OutBlade/s6la8/docs/case-top.png

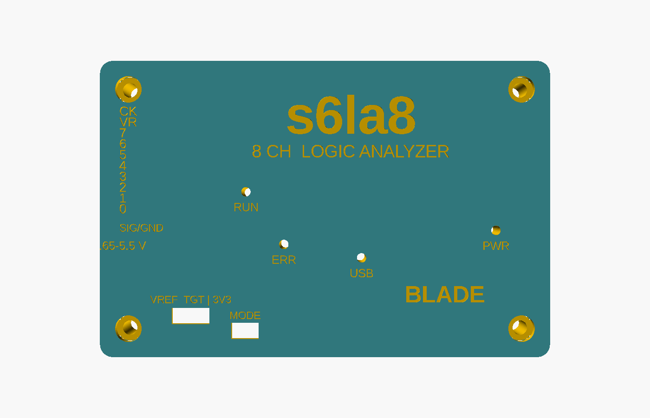
docs/case-top.png
