OutBlade/s6la8/hardware/release/revA/s6la8-revA-bom-jlc.csv

Comment | Designator | Footprint | LCSC Part # | MPN | Manufacturer | Quantity | Note
10uF 10V | C1,C4,C29 | C_0805_2012Metric | C15850 | CL21A106KAYNNNE | Samsung Electro-Mechanics | 3 | JLC basic; 25 V
22uF 6.3V | C2,C3,C5,C6 | C_0805_2012Metric | C45783 | CL21A226MAQNNNE | Samsung Electro-Mechanics | 4 | JLC basic; 25 V
100nF 6.3V | C7,C9,C10,C11,C12,C13,C14,C15,C16,C17,C20,C21,C22,C23,C24,C25,C26,C27,C31,C32,C33,C34,C35,C39,C40,C41,C42,C43,C45,C46,C47,C48,C49,C50,C51,C52,C53,C54,C55 | C_0402_1005Metric | C1525 | CL05B104KO5NNNC | Samsung Electro-Mechanics | 39 | JLC basic
2.2uF 6.3V | C8 | C_0603_1608Metric | C23630 | CL10A225KO8NNNC | Samsung Electro-Mechanics | 1 | JLC basic; 16 V
4.7uF 6.3V | C18,C36,C44 | C_0805_2012Metric | C1779 | CL21A475KAQNNNE | Samsung Electro-Mechanics | 3 | JLC basic; 25 V
1uF | C19 | C_0402_1005Metric | C52923 | CL05A105KA5NQNC | Samsung Electro-Mechanics | 1 | JLC basic; 25 V
10uF 6.3V | C28,C56 | C_0805_2012Metric | C15850 | CL21A106KAYNNNE | Samsung Electro-Mechanics | 2 | JLC basic; 25 V
100nF 10V | C30,C37 | C_0402_1005Metric | C1525 | CL05B104KO5NNNC | Samsung Electro-Mechanics | 2 | JLC basic; 16 V part
1uF 10V | C38 | C_0402_1005Metric | C52923 | CL05A105KA5NQNC | Samsung Electro-Mechanics | 1 | JLC basic; 25 V
18pF | C57,C58 | C_0402_1005Metric | C1549 | CL05C180JB5NNNC | Samsung Electro-Mechanics | 2 | JLC basic; C0G
LED GREEN | D1,D3 | LED_0603_1608Metric |  |  |  | 2 | 0603 green; pick at order
LED RED | D2 | LED_0603_1608Metric |  |  |  | 1 | 0603 red; pick at order
LED YELLOW | D4 | LED_0603_1608Metric |  |  |  | 1 | 0603 yellow; pick at order
220 100MHz | FB1 | R_0603_1608Metric |  |  |  | 1 | ferrite bead 220 ohm at 100 MHz in 0603; pick at order
220 100MHz | FB2 | R_0805_2012Metric |  |  |  | 1 | ferrite bead 220 ohm at 100 MHz in 0805; pick at order
2.54mm 6 x 1 THT Vertical Male | J1 | PinHeader_1x06_P2.54mm_Vertical |  |  |  | 1 | choose at order
2.54mm 2 x 1 THT Vertical Male | J2 | PinHeader_1x02_P2.54mm_Vertical |  |  |  | 1 | choose at order
2.54mm 10 x 2 THT Horizontal Male | J3 | PinHeader_2x10_P2.54mm_Horizontal |  |  |  | 1 | choose at order
USB4105-GF-A | J4 | USB_C_Receptacle_GCT_USB4105-xx-A_16P_TopMnt_Horizontal |  | USB4105-GF-A |  | 1 | IC: MPN is the value
2.54mm 3 x 1 THT Vertical Male | J5 | PinHeader_1x03_P2.54mm_Vertical |  |  |  | 1 | choose at order
2.2uH | L1,L2 | L_1210_3225Metric |  |  |  | 2 | power inductor 2.2 uH, >=1.5 A saturation, 1210; check against TLV62569 datasheet
100k | R1,R2,R3,R9,R11,R13,R15,R17,R19,R21,R23,R28,R40,R61 | R_0402_1005Metric | C25741 | 0402WGF1003TCE | UNI-ROYAL | 14 | JLC basic
453k | R4 | R_0402_1005Metric |  | 0402WGF4533TCE | UNI-ROYAL | 1 | match at order; sets the 3.3 V buck output with 100k
5.1k | R5,R6 | R_0402_1005Metric | C25905 | 0402WGF5101TCE | UNI-ROYAL | 2 | JLC basic
33 | R7,R24,R29,R30,R31,R32,R33,R34,R35,R36,R43 | R_0402_1005Metric | C25105 | 0402WGF330JTCE | UNI-ROYAL | 11 | JLC basic
100 | R8,R10,R12,R14,R16,R18,R20,R22,R27,R60 | R_0402_1005Metric | C25076 | 0402WGF1000TCE | UNI-ROYAL | 10 | JLC basic
1k | R25,R42,R45,R46,R47,R48,R54 | R_0402_1005Metric | C11702 | 0402WGF1001TCE | UNI-ROYAL | 7 | JLC basic
330 | R26 | R_0402_1005Metric | C25104 | 0402WGF3300TCE | UNI-ROYAL | 1 | JLC basic
10k | R37,R38,R39,R41,R51,R52,R57,R58,R59 | R_0402_1005Metric | C25744 | 0402WGF1002TCE | UNI-ROYAL | 9 | JLC basic
4.7k | R44,R49,R50,R53 | R_0402_1005Metric | C25900 | 0402WGF4701TCE | UNI-ROYAL | 4 | JLC basic
2.2k | R55,R56 | R_0402_1005Metric | C25879 | 0402WGF2201TCE | UNI-ROYAL | 2 | JLC basic
24LC128-I/SN | U1 | SOIC-8_3.9x4.9mm_P1.27mm |  | 24LC128-I/SN |  | 1 | IC: MPN is the value
USBLC6-2SC6 | U2,U3,U4,U5,U6 | SOT-23-6 |  | USBLC6-2SC6 |  | 5 | IC: MPN is the value
SN74LVC245APWR | U7 | TSSOP-20_4.4x6.5mm_P0.65mm |  | SN74LVC245APWR |  | 1 | IC: MPN is the value
SN74LVC8T245PWR | U8 | TSSOP-24_4.4x7.8mm_P0.65mm |  | SN74LVC8T245PWR |  | 1 | IC: MPN is the value
SN74LVC2T45DCUR | U9 | VSSOP-8_2.3x2mm_P0.5mm |  | SN74LVC2T45DCUR |  | 1 | IC: MPN is the value
XC6SLX9-2TQG144C | U10 | TQFP-144_20x20mm_P0.5mm | C27408 | XC6SLX9-2TQG144C | AMD Xilinx | 1 | buy from an authorised channel if LCSC stock looks grey-market
CY7C68013A-56PVXC | U11 | SSOP-56_7.5x18.5mm_P0.635mm | C26717 | CY7C68013A-56PVXC | Infineon | 1
TLV62569DBVR | U12,U13 | SOT-23-5 |  | TLV62569DBVR |  | 2 | IC: MPN is the value
MT48LC16M16A2P-6A | U14 | TSOP-II-54_22.2x10.16mm_P0.8mm |  | MT48LC16M16A2P-6A |  | 1 | IC: MPN is the value
ASE-50.000MHZ-LC-T | Y1 | Oscillator_SMD_Abracon_ASE-4Pin_3.2x2.5mm |  | ASE-50.000MHZ-LC-T |  | 1 | IC: MPN is the value
24MHz 12pF | Y2 | Crystal_SMD_3225-4Pin_3.2x2.5mm |  |  |  | 1 | 24 MHz, 12 pF load, 3225; FX2 needs +-100 ppm or better
