OutBlade/s6la8/case/print/s6la8-lid.stl

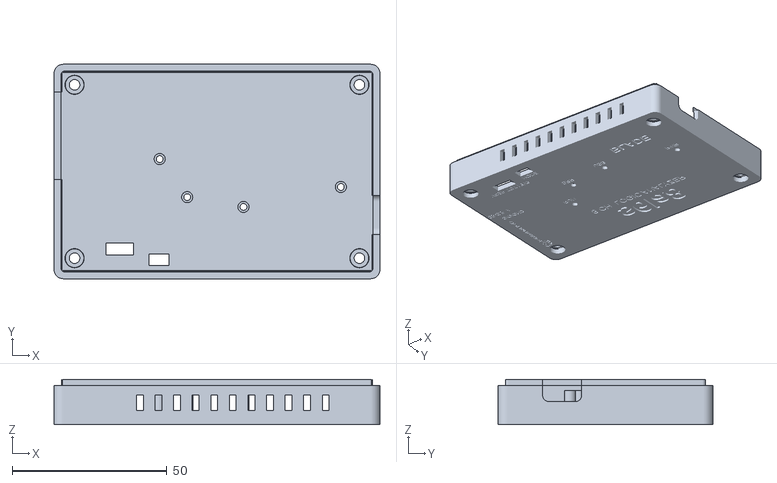
[picture p4: CAD file, 2026-10-16]
case/print/s6la8-lid.stl
105.3 x 69.3 x 14.6
