OutBlade/s6la8/hardware/release/revA/s6la8-revA.step

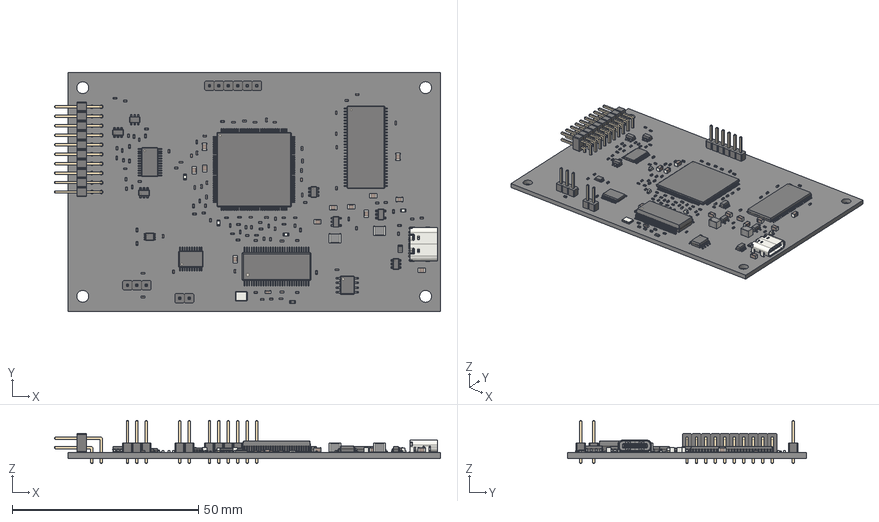
[picture p5: CAD file, 2026-10-16]
hardware/release/revA/s6la8-revA.step
103.6 x 64.0 x 11.5 mm
C_0805_2012Metric x 12
R_0402_1005Metric x 61
SSOP-56_7.5x18.5mm_P0.635mm
SOIC-8_3.9x4.9mm_P1.27mm
C_0402_1005Metric x 45
TSSOP-20_4.4x6.5mm_P0.65mm
C_0603_1608Metric
R_0805_2012Metric
TSOP-II-54_22.2x10.16mm_P0.8mm
R_0603_1608Metric
SOT-23-6 x 5
Crystal_SMD_3225-4Pin_3.2x2.5mm
LED_0603_1608Metric x 4
VSSOP-8_2.3x2mm_P0.5mm
L_1210_3225Metric x 2
SOT-23-5 x 2
USB_C_Receptacle_16P_TopMnt_Horizontal_GCT_USB4105-xx-A
TSSOP-24_4.4x7.8mm_P0.65mm
TQFP-144_20x20mm_P0.5mm
s6la8_PCB
