OutBlade/s6la8/case/print/s6la8-tray.stl

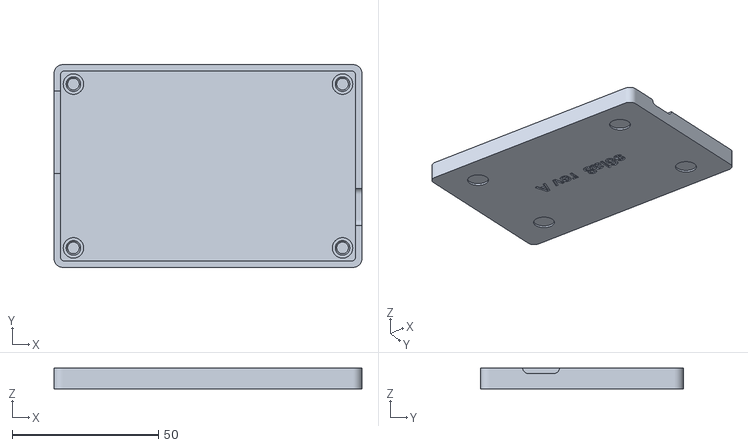
[picture p6: CAD file, 2026-10-16]
case/print/s6la8-tray.stl
105.3 x 69.3 x 7.10
