OutBlade/s6la8/docs/schematic.pdf

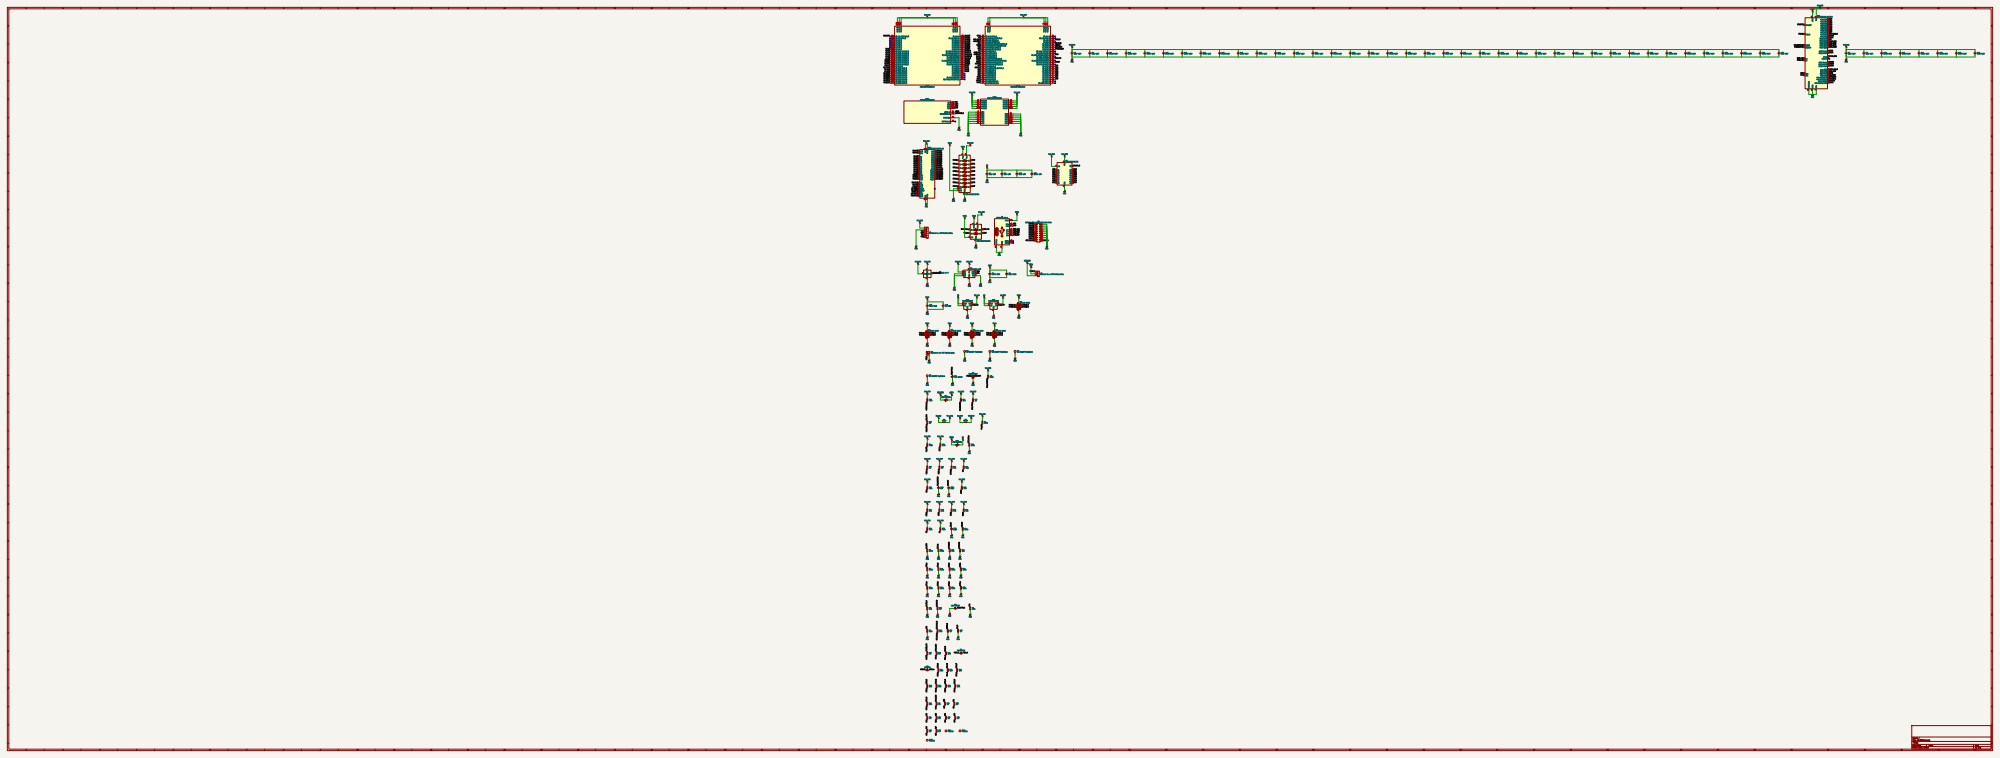
[picture p7: page 1]

2.54mm 2 x 1 THT Vertical Male GND

Size: User | Rev:
KiCad E.D.A. 10.0.6 | Id: 1/1
