OutBlade/s6la8/hardware/release/revA/s6la8-revA-schematic.pdf

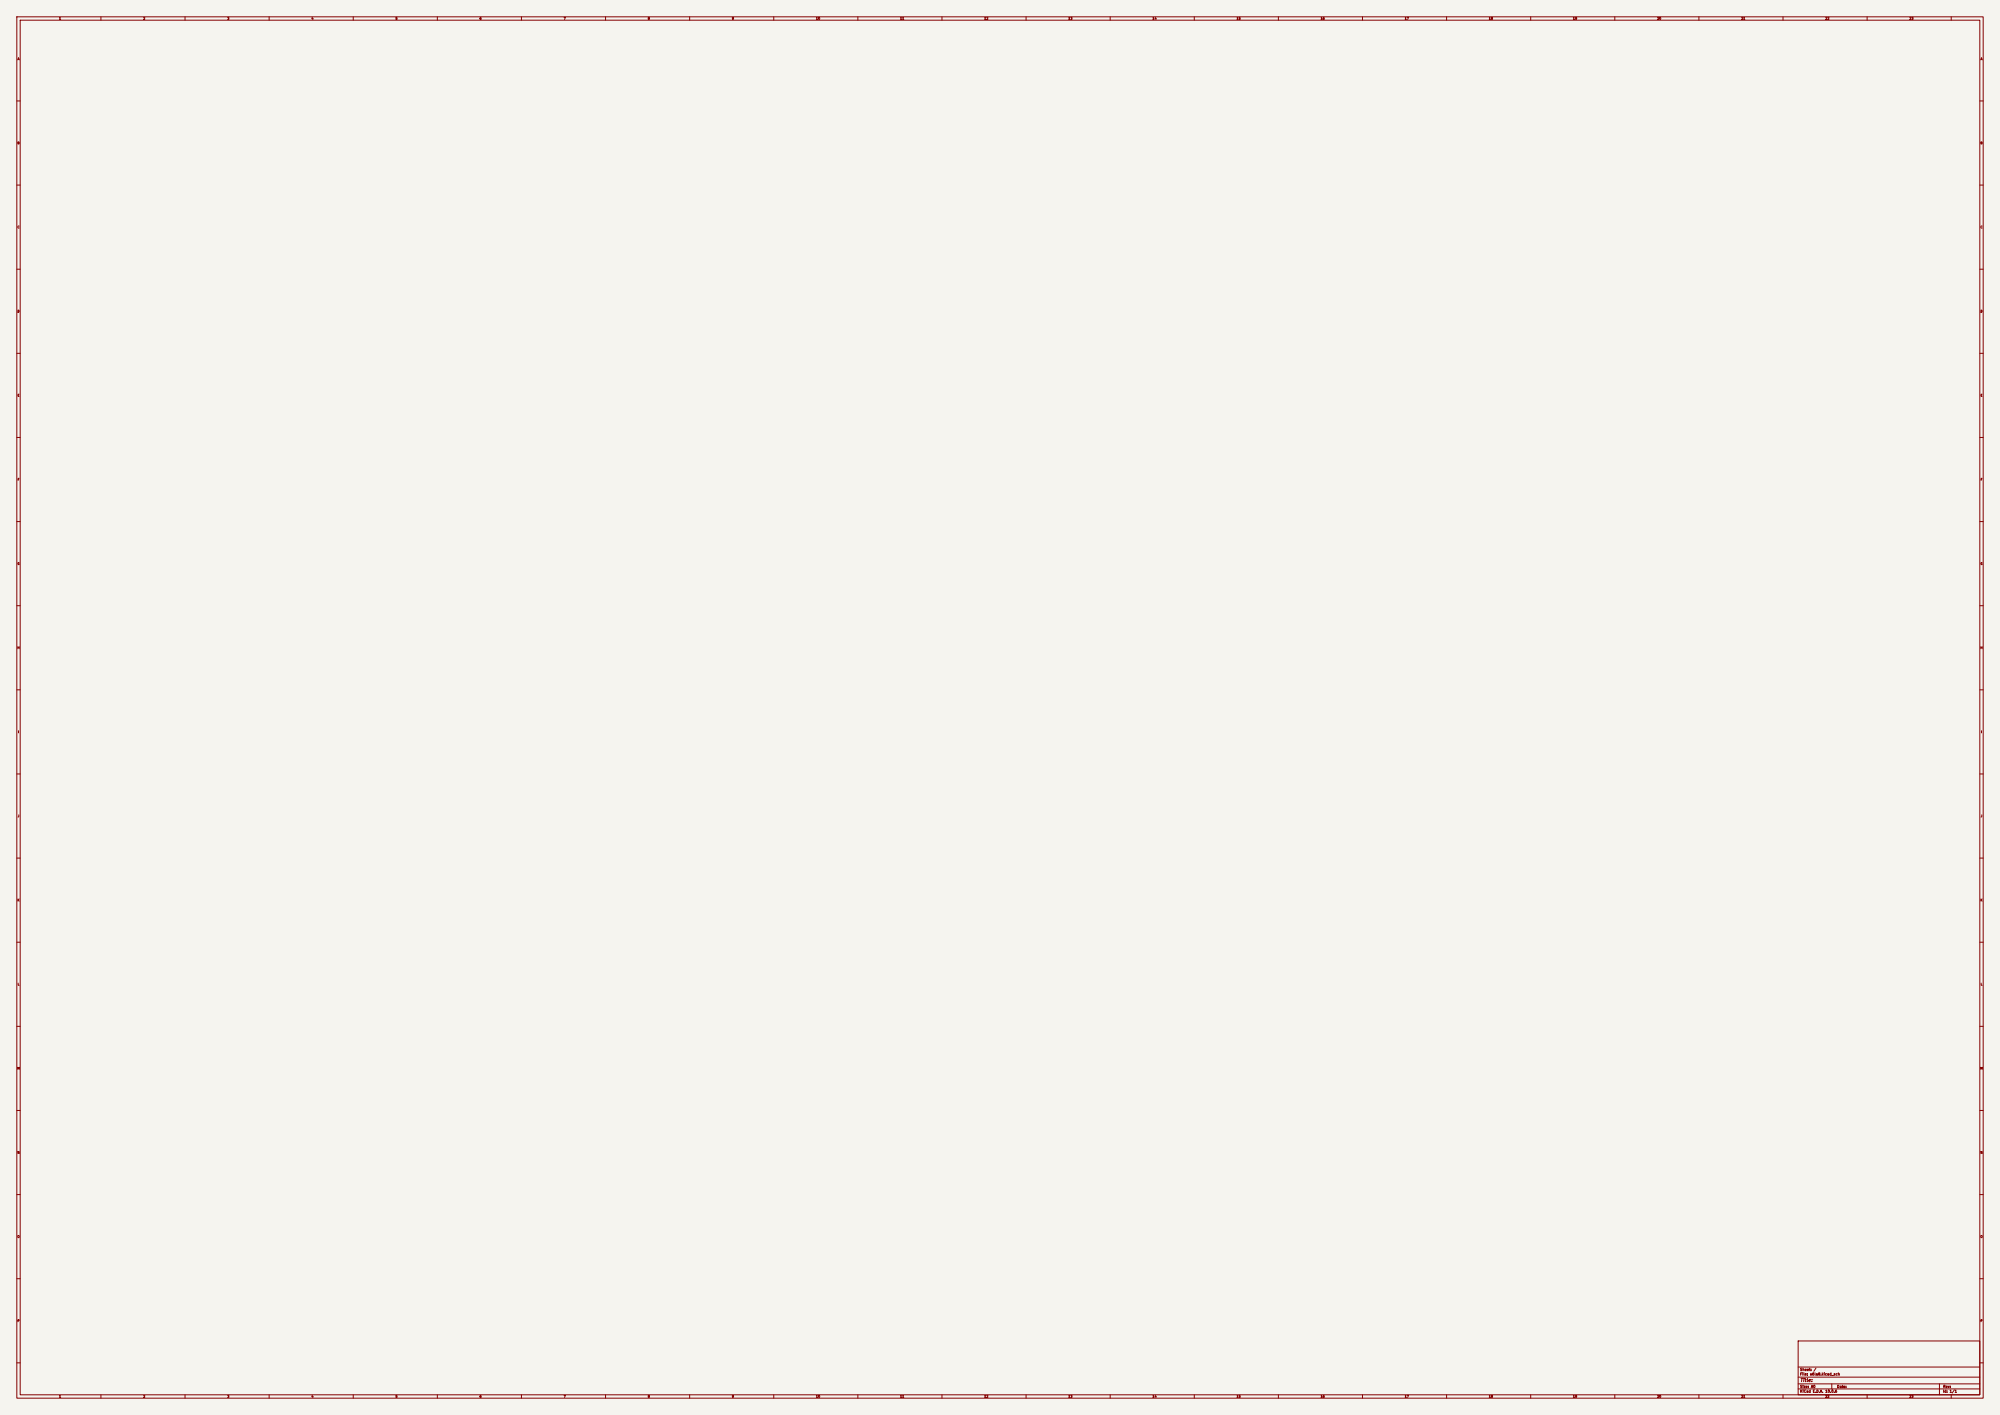
[picture p8: page 1]

Size: A0 | Rev:
KiCad E.D.A. 10.0.6 | Id: 1/1
