OutBlade/s6la8/hardware/release/revA/s6la8-revA-assembly.pdf

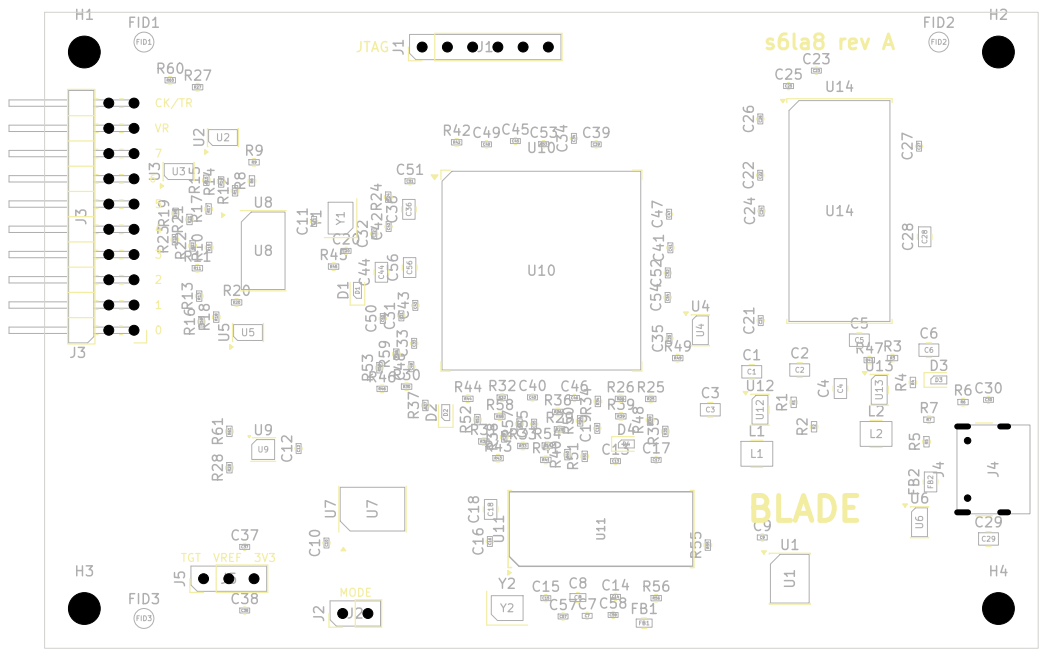
[picture p9: page 1]
