OutBlade/s6la8/hardware/eda/s6la8.kicad_pcb

## KiCad design hardware/eda/s6la8.kicad_pcb (2026-10-16)

Schematic: s6la8.kicad_sch

Parts:
C1, C4, C29: 10uF 10V; C_0805_2012Metric
C2, C3, C5, C6: 22uF 6.3V; C_0805_2012Metric
C7, C9, C10, C11, C12, C13, C14, C15, C16, C17, C20, C21, C22, C23, C24, C25, C26, C27, C31, C32, C33, C34, C35, C39, C40, C41, C42, C43, C45, C46, C47, C48, C49, C50, C51, C52, C53, C54, C55: 100nF 6.3V; C_0402_1005Metric
C8: 2.2uF 6.3V; C_0603_1608Metric
C18, C36, C44: 4.7uF 6.3V; C_0805_2012Metric
C19: 1uF; C_0402_1005Metric
C28, C56: 10uF 6.3V; C_0805_2012Metric
C30, C37: 100nF 10V; C_0402_1005Metric
C38: 1uF 10V; C_0402_1005Metric
C57, C58: 18pF; C_0402_1005Metric
D1, D3: LED GREEN; LED_0603_1608Metric
D2: LED RED; LED_0603_1608Metric
D4: LED YELLOW; LED_0603_1608Metric
FB1: 220 100MHz; R_0603_1608Metric
FB2: 220 100MHz; R_0805_2012Metric
FID1, FID2, FID3: Fiducial; Fiducial_1mm_Mask2mm
H1, H2, H3, H4: M3 DIN965 TopBottom; MountingHole_3.2mm_M3_DIN965_Pad_TopBottom
J1: 2.54mm 6 x 1 THT Vertical Male; PinHeader_1x06_P2.54mm_Vertical
J2: 2.54mm 2 x 1 THT Vertical Male; PinHeader_1x02_P2.54mm_Vertical
J3: 2.54mm 10 x 2 THT Horizontal Male; PinHeader_2x10_P2.54mm_Horizontal
J4: USB4105-GF-A; USB_C_Receptacle_GCT_USB4105-xx-A_16P_TopMnt_Horizontal
J5: 2.54mm 3 x 1 THT Vertical Male; PinHeader_1x03_P2.54mm_Vertical
L1, L2: 2.2uH; L_1210_3225Metric
R1, R2, R3, R9, R11, R13, R15, R17, R19, R21, R23, R28, R40, R61: 100k; R_0402_1005Metric
R4: 453k; R_0402_1005Metric
R5, R6: 5.1k; R_0402_1005Metric
R7, R24, R29, R30, R31, R32, R33, R34, R35, R36, R43: 33; R_0402_1005Metric
R8, R10, R12, R14, R16, R18, R20, R22, R27, R60: 100; R_0402_1005Metric
R25, R42, R45, R46, R47, R48, R54: 1k; R_0402_1005Metric
R26: 330; R_0402_1005Metric
R37, R38, R39, R41, R51, R52, R57, R58, R59: 10k; R_0402_1005Metric
R44, R49, R50, R53: 4.7k; R_0402_1005Metric
R55, R56: 2.2k; R_0402_1005Metric
U1: 24LC128-I/SN; SOIC-8_3.9x4.9mm_P1.27mm
U2, U3, U4, U5, U6: USBLC6-2SC6; SOT-23-6
U7: SN74LVC245APWR; TSSOP-20_4.4x6.5mm_P0.65mm
U8: SN74LVC8T245PWR; TSSOP-24_4.4x7.8mm_P0.65mm
U9: SN74LVC2T45DCUR; VSSOP-8_2.3x2mm_P0.5mm
U10: XC6SLX9-2TQG144C; TQFP-144_20x20mm_P0.5mm
U11: CY7C68013A-56PVXC; SSOP-56_7.5x18.5mm_P0.635mm
U12, U13: TLV62569DBVR; SOT-23-5
U14: MT48LC16M16A2P-6A; TSOP-II-54_22.2x10.16mm_P0.8mm
Y1: ASE-50.000MHZ-LC-T; Oscillator_SMD_Abracon_ASE-4Pin_3.2x2.5mm
Y2: 24MHz 12pF; Crystal_SMD_3225-4Pin_3.2x2.5mm

Connections:
AVCC: C7.1, C8.1, FB1.2, U11.10 (AVCC), U11.14 (AVCC)
CC1: J4.A5 (CC1), R5.1
CC2: J4.B5 (CC2), R6.1
CCLK: R7.2, U10.70 (IO_L1P_CCLK_2)
CCLK_SRC: R7.1, U11.56 (PD4/FD12)
CH0: U7.2 (A1), U8.21 (B1), U10.5 (IO_L52N_3)
CH0_A: R8.2, R9.1, U2.1 (I/O1), U2.6 (I/O1), U8.3 (A1)
CH0_IN: J3.1, R8.1
CH1: U7.3 (A2), U8.20 (B2), U10.6 (IO_L52P_3)
CH1_A: R10.2, R11.1, U2.3 (I/O2), U2.4 (I/O2), U8.4 (A2)
CH1_IN: J3.3, R10.1
CH2: U7.4 (A3), U8.19 (B3), U10.7 (IO_L51N_3)
CH2_A: R12.2, R13.1, U3.1 (I/O1), U3.6 (I/O1), U8.5 (A3)
CH2_IN: J3.5, R12.1
CH3: U7.5 (A4), U8.18 (B4), U10.8 (IO_L51P_3)
CH3_A: R14.2, R15.1, U3.3 (I/O2), U3.4 (I/O2), U8.6 (A4)
CH3_IN: J3.7, R14.1
CH4: U7.6 (A5), U8.17 (B5), U10.9 (IO_L50N_3)
CH4_A: R16.2, R17.1, U4.1 (I/O1), U4.6 (I/O1), U8.7 (A5)
CH4_IN: J3.9, R16.1
CH5: U7.7 (A6), U8.16 (B6), U10.10 (IO_L50P_3)
CH5_A: R18.2, R19.1, U4.3 (I/O2), U4.4 (I/O2), U8.8 (A6)
CH5_IN: J3.11, R18.1
CH6: U7.8 (A7), U8.15 (B7), U10.11 (IO_L49N_3)
CH6_A: R20.2, R21.1, U5.1 (I/O1), U5.6 (I/O1), U8.9 (A7)
CH6_IN: J3.13, R20.1
CH7: U7.9 (A8), U8.14 (B8), U10.12 (IO_L49P_3)
CH7_A: R22.2, R23.1, U5.3 (I/O2), U5.4 (I/O2), U8.10 (A8)
CH7_IN: J3.15, R22.1
CLK50: R24.2, U10.15 (IO_L44P_GCLK21_3)
CLK50_SRC: R24.1, Y1.3 (OUT)
CSI_B: R25.1, U10.64 (IO_L3N_MOSI_CSI_B_MISO0_2)
DONE: R26.2, U10.71 (DONE_2), U11.54 (PD2/FD10)
EXT_CLK: U9.7 (B1), U10.17 (IO_L43P_GCLK23_3)
EXT_CLK_A: R27.2, R28.1, U9.2 (A1)
EXT_CLK_IN: J3.19, R27.1
FB0: R29.1, U7.18 (B1)
FB1: R30.1, U7.17 (B2)
FB2: R31.1, U7.16 (B3)
FB3: R32.1, U7.15 (B4)
FB4: R33.1, U7.14 (B5)
FB5: R34.1, U7.13 (B6)
FB6: R35.1, U7.12 (B7)
FB7: R36.1, U7.11 (B8)
FB_1V2: R1.1, R2.2, U12.5 (FB)
FB_3V3: R3.1, R4.2, U13.5 (FB)
FB_OE_N: R37.1, U7.19 (~OE), U10.30 (IO_L36P_3), U11.43 (PA3/WU2)
FD0: R29.2, U10.48 (IO_L48P_D7_2), U11.25 (PB0/FD0)
FD1: R30.2, U10.43 (IO_L62N_D6_2), U11.26 (PB1/FD1)
FD2: R31.2, U10.44 (IO_L62P_D5_2), U11.27 (PB2/FD2)
FD3: R32.2, U10.45 (IO_L49N_D4_2), U11.28 (PB3/FD3)
FD4: R33.2, U10.46 (IO_L49P_D3_2), U11.29 (PB4/FD4)
FD5: R34.2, U10.61 (IO_L12N_D2_MISO3_2), U11.30 (PB5/FD5)
FD6: R35.2, U10.62 (IO_L12P_D1_MISO2_2), U11.31 (PB6/FD6)
FD7: R36.2, U10.65 (IO_L3P_D0_DIN_MISO_MISO1_2), U11.32 (PB7/FD7)
FIFOADR0: R38.1, U10.58 (IO_L14P_D11_2), U11.44 (PA4/FIOADDR0)
FIFOADR1: R39.1, U10.59 (IO_L13N_D10_2), U11.45 (PA5/FIOADDR1)
FLAGA: U10.51 (IO_L31P_GCLK31_D14_2), U11.36 (CTL0/FLAGA)
FLAGB: U10.56 (IO_L30P_GCLK1_D13_2), U11.37 (CTL1/FLAGB)
FLAGC: U10.57 (IO_L14N_D12_2), U11.38 (CTL2/FLAGC)
FPGA_IRQ_N: U10.26 (IO_L37N_3), U11.40 (PA0/~INT0)
FX2_RESET_N: C19.1, R40.2, U11.49 (~RESET)
FX2_WAKEUP: R41.2, U11.51 (WAKEUP)
GND: C1.2, C2.2, C3.2, C4.2, C5.2, C6.2, C7.2, C8.2, C9.2, C10.2, C11.2, C12.2, C13.2, C14.2, C15.2, C16.2, C17.2, C18.2, C19.2, C20.2, C21.2, C22.2, C23.2, C24.2, C25.2, C26.2, C27.2, C28.2, C29.2, C30.2, C31.2, C32.2, C33.2, C34.2, C35.2, C36.2, C37.2, C38.2, C39.2, C40.2, C41.2, C42.2, C43.2, C44.2, C45.2, C46.2, C47.2, C48.2, C49.2, C50.2, C51.2, C52.2, C53.2, C54.2, C55.2, C56.2, C57.2, C58.2, D3.1 (K), D4.1 (K), H1.1, H2.1, H3.1, H4.1, J1.2, J2.2, J3.2, J3.4, J3.6, J3.8, J3.10, J3.12, J3.14, J3.16, J3.18, J4.A1 (GND), J4.A12 (GND), J4.B1 (GND), J4.B12 (GND), J4.SH (SHIELD), R1.2, R3.2, R5.2, R6.2, R9.2, R11.2, R13.2, R15.2, R17.2, R19.2, R21.2, R23.2, R25.2, R28.2, R37.2, R38.2, R39.2, R42.2, R54.2, R61.2, U1.2 (A1), U1.3 (A2), U1.4 (GND), U1.7 (WP), U2.2 (GND), U3.2 (GND), U4.2 (GND), U5.2 (GND), U6.2 (GND), U7.10 (GND), U8.11 (GND), U8.12 (GND), U8.13 (GND), U8.22 (~OE), U9.4 (GND), U10.3 (GND), U10.13 (GND), U10.25 (GND), U10.49 (GND), U10.54 (GND), U10.68 (GND), U10.73 (SUSPEND), U10.77 (GND), U10.91 (GND), U10.96 (GND), U10.108 (GND), U10.113 (GND), U10.130 (GND), U10.136 (GND), U11.4 (GND), U11.7 (GND), U11.13 (AGND), U11.17 (AGND), U11.19 (GND), U11.21 (RESERVED), U11.33 (GND), U11.35 (GND), U11.48 (GND), U12.2 (GND), U13.2 (GND), U14.6 (VSSQ), U14.12 (VSSQ), U14.28 (VSS), U14.41 (VSS), U14.46 (VSSQ), U14.52 (VSSQ), U14.54 (VSS), Y1.2 (GND), Y2.2 (G), Y2.4 (G)
HSWAPEN: R42.1, U10.144 (IO_L1P_HSWAPEN_0)
IFCLK: R43.2, U10.55 (IO_L30N_GCLK0_USERCCLK_2)
IFCLK_SRC: R43.1, U11.20 (IFCLK)
INIT_B: R44.2, U10.39 (IO_L65P_INIT_B_2), U11.53 (PD1/FD9)
LED1_A: D1.2 (A), R45.2
LED1_K: D1.1 (K), U10.29 (IO_L36N_3)
LED2_A: D2.2 (A), R46.2
LED2_K: D2.1 (K), U10.33 (IO_L2P_3)
LED_PWR_A: D3.2 (A), R47.2
LED_USB: R48.1, U11.41 (PA1/~INT1)
LED_USB_A: D4.2 (A), R48.2
M0: R49.2, U10.69 (IO_L1N_M0_CMPMISO_2), U11.55 (PD3/FD11)
M1: R50.2, U10.60 (IO_L13P_M1_2)
MODE: J2.1, R51.2, U11.47 (PA7/FLAGD/~SLCS)
NC_J_USB_SBU1: J4.A8 (SBU1)
NC_J_USB_SBU2: J4.B8 (SBU2)
NC_U_FPGA_CMPCS_B_2: U10.72 (CMPCS_B_2)
NC_U_FPGA_IO_L1N_VREF_0: U10.143 (IO_L1N_VREF_0)
NC_U_FPGA_IO_L1N_VREF_3: U10.34 (IO_L1N_VREF_3)
NC_U_FPGA_IO_L1P_3: U10.35 (IO_L1P_3)
NC_U_FPGA_IO_L2N_0: U10.141 (IO_L2N_0)
NC_U_FPGA_IO_L2N_3: U10.32 (IO_L2N_3)
NC_U_FPGA_IO_L2P_0: U10.142 (IO_L2P_0)
NC_U_FPGA_IO_L3N_0: U10.139 (IO_L3N_0)
NC_U_FPGA_IO_L3P_0: U10.140 (IO_L3P_0)
NC_U_FPGA_IO_L4P_0: U10.138 (IO_L4P_0)
NC_U_FPGA_IO_L41N_GCLK26_3: U10.23 (IO_L41N_GCLK26_3)
NC_U_FPGA_IO_L41P_GCLK27_3: U10.24 (IO_L41P_GCLK27_3)
NC_U_FPGA_IO_L42N_GCLK24_3: U10.21 (IO_L42N_GCLK24_3)
NC_U_FPGA_IO_L43N_GCLK22_IRDY2_3: U10.16 (IO_L43N_GCLK22_IRDY2_3)
NC_U_FPGA_IO_L44N_GCLK20_3: U10.14 (IO_L44N_GCLK20_3)
NC_U_FPGA_IO_L47N_1: U10.78 (IO_L47N_1)
NC_U_FPGA_IO_L47P_1: U10.79 (IO_L47P_1)
NC_U_FPGA_IO_L74N_DOUT_BUSY_1: U10.74 (IO_L74N_DOUT_BUSY_1)
NC_U_FPGA_IO_L74P_AWAKE_1: U10.75 (IO_L74P_AWAKE_1)
NC_U_FPGA_IO_L83N_VREF_3: U10.1 (IO_L83N_VREF_3)
NC_U_FPGA_IO_L83P_3: U10.2 (IO_L83P_3)
NC_U_FX2_CLKOUT: U11.5 (CLKOUT)
NC_U_SDRAM_NC: U14.40 (NC)
PKTEND: R52.2, U10.50 (IO_L31N_GCLK30_D15_2), U11.46 (PA6/PKTEND)
PROGRAM_B: R53.2, U10.37 (PROGRAM_B_2), U11.52 (PD0/FD8)
RDWR_B: R54.1, U10.47 (IO_L48N_RDWR_B_VREF_2)
REG_CS_N: U10.67 (IO_L2P_CMPCLK_2), U11.3 (PD7/FD15)
REG_MISO: U10.27 (IO_L37P_3), U11.2 (PD6/FD14)
REG_MOSI: U10.66 (IO_L2N_CMPMOSI_2), U11.1 (PD5/FD13)
SCL: R55.2, U1.6 (SCL), U11.22 (SCL)
SDA: R56.2, U1.5 (SDA), U11.23 (SDA)
SD_A0: U10.83 (IO_L45P_1), U14.23 (A0)
SD_A1: U10.82 (IO_L45N_1), U14.24 (A1)
SD_A2: U10.81 (IO_L46P_1), U14.25 (A2)
SD_A3: U10.80 (IO_L46N_1), U14.26 (A3)
SD_A4: U10.137 (IO_L4N_0), U14.29 (A4)
SD_A5: U10.134 (IO_L34P_GCLK19_0), U14.30 (A5)
SD_A6: U10.133 (IO_L34N_GCLK18_0), U14.31 (A6)
SD_A7: U10.132 (IO_L35P_GCLK17_0), U14.32 (A7)
SD_A8: U10.131 (IO_L35N_GCLK16_0), U14.33 (A8)
SD_A9: U10.127 (IO_L36P_GCLK15_0), U14.34 (A9)
SD_A10: U10.84 (IO_L43N_GCLK4_1), U14.22 (A10)
SD_A11: U10.126 (IO_L36N_GCLK14_0), U14.35 (A11)
SD_A12: U10.124 (IO_L37P_GCLK13_0), U14.36 (A12)
SD_BA0: U10.87 (IO_L42N_GCLK6_TRDY1_1), U14.20 (BA0)
SD_BA1: U10.85 (IO_L43P_GCLK5_1), U14.21 (BA1)
SD_CAS_N: U10.93 (IO_L41P_GCLK9_IRDY1_1), U14.17 (~CAS)
SD_CKE: U10.123 (IO_L37N_GCLK12_0), U14.37 (CKE)
SD_CLK: U10.121 (IO_L62P_0), U14.38 (CLK)
SD_CS_N: U10.88 (IO_L42P_GCLK7_1), U14.19 (~CS)
SD_DQ0: U10.105 (IO_L1P_1), U14.2 (DQ0)
SD_DQ1: U10.104 (IO_L1N_VREF_1), U14.4 (DQ1)
SD_DQ2: U10.102 (IO_L32P_1), U14.5 (DQ2)
SD_DQ3: U10.101 (IO_L32N_1), U14.7 (DQ3)
SD_DQ4: U10.100 (IO_L33P_1), U14.8 (DQ4)
SD_DQ5: U10.99 (IO_L33N_1), U14.10 (DQ5)
SD_DQ6: U10.98 (IO_L34P_1), U14.11 (DQ6)
SD_DQ7: U10.97 (IO_L34N_1), U14.13 (DQ7)
SD_DQ8: U10.119 (IO_L63P_SCP7_0), U14.42 (DQ8)
SD_DQ9: U10.118 (IO_L63N_SCP6_0), U14.44 (DQ9)
SD_DQ10: U10.117 (IO_L64P_SCP5_0), U14.45 (DQ10)
SD_DQ11: U10.116 (IO_L64N_SCP4_0), U14.47 (DQ11)
SD_DQ12: U10.115 (IO_L65P_SCP3_0), U14.48 (DQ12)
SD_DQ13: U10.114 (IO_L65N_SCP2_0), U14.50 (DQ13)
SD_DQ14: U10.112 (IO_L66P_SCP1_0), U14.51 (DQ14)
SD_DQ15: U10.111 (IO_L66N_SCP0_0), U14.53 (DQ15)
SD_DQMH: U10.120 (IO_L62N_VREF_0), U14.39 (DQMH)
SD_DQML: U10.95 (IO_L40P_GCLK11_1), U14.15 (DQML)
SD_RAS_N: U10.92 (IO_L41N_GCLK8_1), U14.18 (~RAS)
SD_WE_N: U10.94 (IO_L40N_GCLK10_1), U14.16 (~WE)
SLOE: R57.2, U10.41 (IO_L64P_D8_2), U11.42 (PA2/SLOE)
SLRD: R58.2, U10.40 (IO_L64N_D9_2), U11.8 (RDY0/SLRD)
SLWR: R59.2, U10.38 (IO_L65N_CSO_B_2), U11.9 (RDY1/SLWR)
SW_1V2: L1.1, U12.3 (SW)
SW_3V3: L2.1, U13.3 (SW)
TCK: J1.3, U10.109 (TCK)
TDI: J1.5, U10.110 (TDI)
TDO: J1.4, U10.106 (TDO)
TMS: J1.6, U10.107 (TMS)
TRIG: U9.6 (B2), U10.22 (IO_L42P_GCLK25_TRDY2_3)
TRIG_A: R60.2, R61.1, U9.3 (A2)
TRIG_IN: J3.20, R60.1
USB_D_N: J4.A7 (D-), J4.B7 (D-), U6.3 (I/O2), U6.4 (I/O2), U11.16 (D-)
USB_D_P: J4.A6 (D+), J4.B6 (D+), U6.1 (I/O1), U6.6 (I/O1), U11.15 (D+)
V5: C1.1, C4.1, C29.1, C30.1, FB2.2, U12.1 (EN), U12.4 (VIN), U13.1 (EN), U13.4 (VIN)
VBUS: FB2.1, J4.A4 (VBUS), J4.A9 (VBUS), J4.B4 (VBUS), J4.B9 (VBUS), U6.5 (VBUS)
VCCA: C37.1, C38.1, J5.2, U2.5 (VBUS), U3.5 (VBUS), U4.5 (VBUS), U5.5 (VBUS), U8.1 (V_{CCA}), U8.2 (DIR), U9.1 (VCCA), U9.5 (DIR)
VCC_1V2: C2.1, C3.1, C39.1, C40.1, C41.1, C42.1, C43.1, C44.1, L1.2, R2.1, U10.19 (VCCINT), U10.28 (VCCINT), U10.52 (VCCINT), U10.89 (VCCINT), U10.128 (VCCINT)
VCC_3V3: C5.1, C6.1, C9.1, C10.1, C11.1, C12.1, C13.1, C14.1, C15.1, C16.1, C17.1, C18.1, C20.1, C21.1, C22.1, C23.1, C24.1, C25.1, C26.1, C27.1, C28.1, C31.1, C32.1, C33.1, C34.1, C35.1, C36.1, C45.1, C46.1, C47.1, C48.1, C49.1, C50.1, C51.1, C52.1, C53.1, C54.1, C55.1, C56.1, FB1.1, J1.1, J5.3, L2.2, R4.1, R26.1, R40.1, R41.1, R44.1, R45.1, R46.1, R47.1, R49.1, R50.1, R51.1, R52.1, R53.1, R55.1, R56.1, R57.1, R58.1, R59.1, U1.1 (A0), U1.8 (VCC), U7.1 (DIR), U7.20 (VCC), U8.23 (V_{CCB}), U8.24 (V_{CCB}), U9.8 (VCCB), U10.4 (VCCO_3), U10.18 (VCCO_3), U10.20 (VCCAUX), U10.31 (VCCO_3), U10.36 (VCCAUX), U10.42 (VCCO_2), U10.53 (VCCAUX), U10.63 (VCCO_2), U10.76 (VCCO_1), U10.86 (VCCO_1), U10.90 (VCCAUX), U10.103 (VCCO_1), U10.122 (VCCO_0), U10.125 (VCCO_0), U10.129 (VCCAUX), U10.135 (VCCO_0), U11.6 (VCC), U11.18 (VCC), U11.24 (VCC), U11.34 (VCC), U11.39 (VCC), U11.50 (VCC), U14.1 (VDD), U14.3 (VDDQ), U14.9 (VDDQ), U14.14 (VDD), U14.27 (VDD), U14.43 (VDDQ), U14.49 (VDDQ), Y1.1 (EN), Y1.4 (Vdd)
VREF_T: J3.17, J5.1
XTALIN: C57.1, U11.12 (XTALIN), Y2.1
XTALOUT: C58.1, U11.11 (XTALOUT), Y2.3

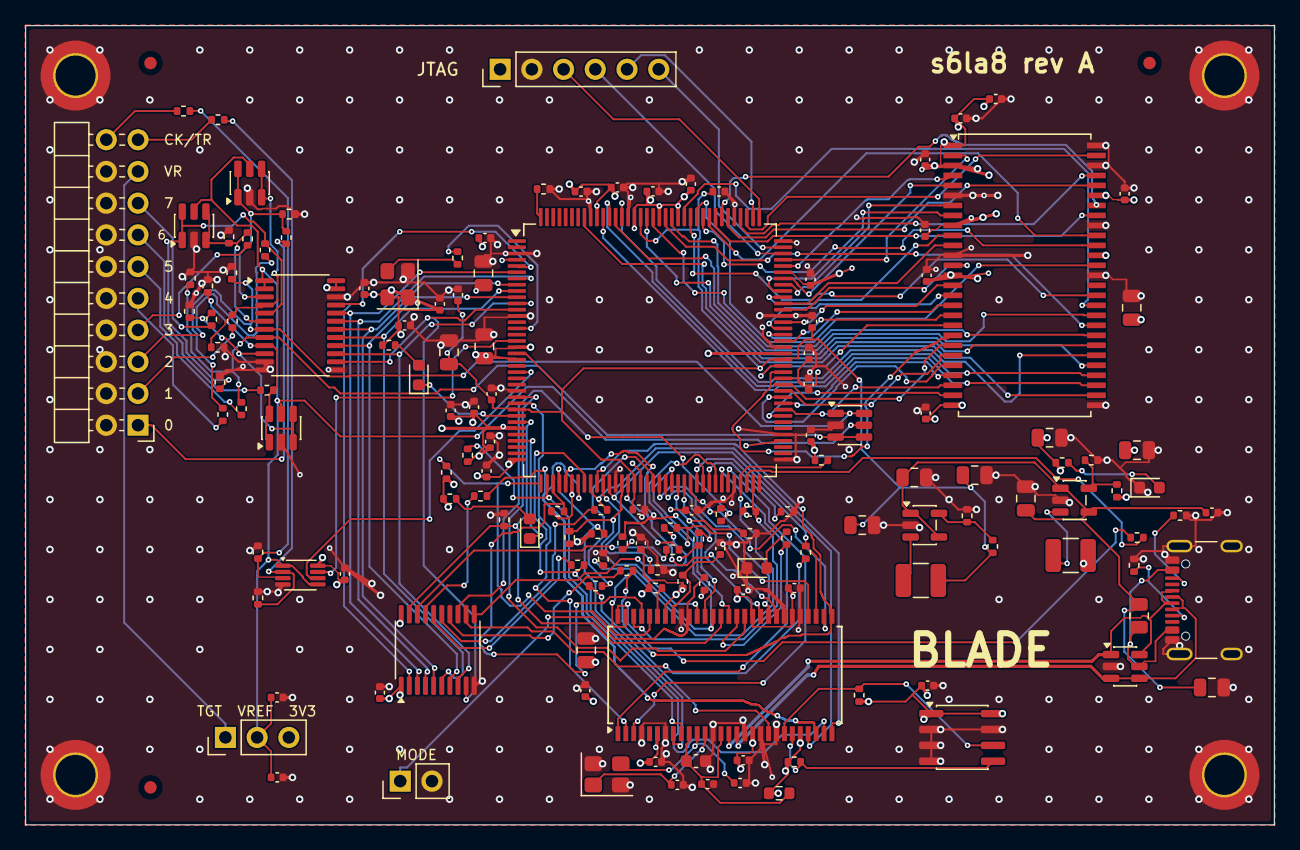
[picture p10: board s6la8.kicad_pcb from above]

Board: 4 copper layers, 100.0 x 64.0 mm, 155 parts (0 on the bottom side), 147 nets.
