OutBlade/s6la8/gateware/ise/pins.ucf

# Generated by hardware/gen_pins.py from the schematic. Do not edit.
CONFIG VCCAUX = "3.3";

NET "CCLK" LOC = P70 | IOSTANDARD = LVCMOS33;
NET "CH<0>" LOC = P5 | IOSTANDARD = LVCMOS33;
NET "CH<1>" LOC = P6 | IOSTANDARD = LVCMOS33;
NET "CH<2>" LOC = P7 | IOSTANDARD = LVCMOS33;
NET "CH<3>" LOC = P8 | IOSTANDARD = LVCMOS33;
NET "CH<4>" LOC = P9 | IOSTANDARD = LVCMOS33;
NET "CH<5>" LOC = P10 | IOSTANDARD = LVCMOS33;
NET "CH<6>" LOC = P11 | IOSTANDARD = LVCMOS33;
NET "CH<7>" LOC = P12 | IOSTANDARD = LVCMOS33;
NET "CLK50" LOC = P15 | IOSTANDARD = LVCMOS33;
NET "EXT_CLK" LOC = P17 | IOSTANDARD = LVCMOS33;
NET "FB_OE_N" LOC = P30 | IOSTANDARD = LVCMOS33;
NET "FD<0>" LOC = P48 | IOSTANDARD = LVCMOS33;
NET "FD<1>" LOC = P43 | IOSTANDARD = LVCMOS33;
NET "FD<2>" LOC = P44 | IOSTANDARD = LVCMOS33;
NET "FD<3>" LOC = P45 | IOSTANDARD = LVCMOS33;
NET "FD<4>" LOC = P46 | IOSTANDARD = LVCMOS33;
NET "FD<5>" LOC = P61 | IOSTANDARD = LVCMOS33;
NET "FD<6>" LOC = P62 | IOSTANDARD = LVCMOS33;
NET "FD<7>" LOC = P65 | IOSTANDARD = LVCMOS33;
NET "FIFOADR0" LOC = P58 | IOSTANDARD = LVCMOS33;
NET "FIFOADR1" LOC = P59 | IOSTANDARD = LVCMOS33;
NET "FLAGA" LOC = P51 | IOSTANDARD = LVCMOS33;
NET "FLAGB" LOC = P56 | IOSTANDARD = LVCMOS33;
NET "FLAGC" LOC = P57 | IOSTANDARD = LVCMOS33;
NET "FPGA_IRQ_N" LOC = P26 | IOSTANDARD = LVCMOS33;
NET "IFCLK" LOC = P55 | IOSTANDARD = LVCMOS33;
NET "LED1_K" LOC = P29 | IOSTANDARD = LVCMOS33;
NET "LED2_K" LOC = P33 | IOSTANDARD = LVCMOS33;
NET "PKTEND" LOC = P50 | IOSTANDARD = LVCMOS33;
NET "REG_CS_N" LOC = P67 | IOSTANDARD = LVCMOS33;
NET "REG_MISO" LOC = P27 | IOSTANDARD = LVCMOS33;
NET "REG_MOSI" LOC = P66 | IOSTANDARD = LVCMOS33;
NET "SD_A<0>" LOC = P83 | IOSTANDARD = LVCMOS33;
NET "SD_A<1>" LOC = P82 | IOSTANDARD = LVCMOS33;
NET "SD_A<2>" LOC = P81 | IOSTANDARD = LVCMOS33;
NET "SD_A<3>" LOC = P80 | IOSTANDARD = LVCMOS33;
NET "SD_A<4>" LOC = P137 | IOSTANDARD = LVCMOS33;
NET "SD_A<5>" LOC = P134 | IOSTANDARD = LVCMOS33;
NET "SD_A<6>" LOC = P133 | IOSTANDARD = LVCMOS33;
NET "SD_A<7>" LOC = P132 | IOSTANDARD = LVCMOS33;
NET "SD_A<8>" LOC = P131 | IOSTANDARD = LVCMOS33;
NET "SD_A<9>" LOC = P127 | IOSTANDARD = LVCMOS33;
NET "SD_A<10>" LOC = P84 | IOSTANDARD = LVCMOS33;
NET "SD_A<11>" LOC = P126 | IOSTANDARD = LVCMOS33;
NET "SD_A<12>" LOC = P124 | IOSTANDARD = LVCMOS33;
NET "SD_BA0" LOC = P87 | IOSTANDARD = LVCMOS33;
NET "SD_BA1" LOC = P85 | IOSTANDARD = LVCMOS33;
NET "SD_CAS_N" LOC = P93 | IOSTANDARD = LVCMOS33;
NET "SD_CKE" LOC = P123 | IOSTANDARD = LVCMOS33;
NET "SD_CLK" LOC = P121 | IOSTANDARD = LVCMOS33;
NET "SD_CS_N" LOC = P88 | IOSTANDARD = LVCMOS33;
NET "SD_DQ<0>" LOC = P105 | IOSTANDARD = LVCMOS33;
NET "SD_DQ<1>" LOC = P104 | IOSTANDARD = LVCMOS33;
NET "SD_DQ<2>" LOC = P102 | IOSTANDARD = LVCMOS33;
NET "SD_DQ<3>" LOC = P101 | IOSTANDARD = LVCMOS33;
NET "SD_DQ<4>" LOC = P100 | IOSTANDARD = LVCMOS33;
NET "SD_DQ<5>" LOC = P99 | IOSTANDARD = LVCMOS33;
NET "SD_DQ<6>" LOC = P98 | IOSTANDARD = LVCMOS33;
NET "SD_DQ<7>" LOC = P97 | IOSTANDARD = LVCMOS33;
NET "SD_DQ<8>" LOC = P119 | IOSTANDARD = LVCMOS33;
NET "SD_DQ<9>" LOC = P118 | IOSTANDARD = LVCMOS33;
NET "SD_DQ<10>" LOC = P117 | IOSTANDARD = LVCMOS33;
NET "SD_DQ<11>" LOC = P116 | IOSTANDARD = LVCMOS33;
NET "SD_DQ<12>" LOC = P115 | IOSTANDARD = LVCMOS33;
NET "SD_DQ<13>" LOC = P114 | IOSTANDARD = LVCMOS33;
NET "SD_DQ<14>" LOC = P112 | IOSTANDARD = LVCMOS33;
NET "SD_DQ<15>" LOC = P111 | IOSTANDARD = LVCMOS33;
NET "SD_DQMH" LOC = P120 | IOSTANDARD = LVCMOS33;
NET "SD_DQML" LOC = P95 | IOSTANDARD = LVCMOS33;
NET "SD_RAS_N" LOC = P92 | IOSTANDARD = LVCMOS33;
NET "SD_WE_N" LOC = P94 | IOSTANDARD = LVCMOS33;
NET "SLOE" LOC = P41 | IOSTANDARD = LVCMOS33;
NET "SLRD" LOC = P40 | IOSTANDARD = LVCMOS33;
NET "SLWR" LOC = P38 | IOSTANDARD = LVCMOS33;
NET "TRIG" LOC = P22 | IOSTANDARD = LVCMOS33;
