OutBlade/s6la8/(commit log)

2026-10-13 Initial design: schematic, layout, firmware, gateware and sigrok driver
    Nothing here has been built or tested on hardware. The layout is
    autorouted with 17 connections still open; the gateware has only been
    simulated; the firmware and driver only compile.
2026-10-13 Layout scripts: lockable plane vias, stitching, router limits documented
    Placing plane vias before routing reaches every power pad, but the
    Freerouting build in use fails on boards with existing wiring, so the
    committed board is still the route-then-fanout result with 17 open
    connections.
2026-10-13 Try Freerouting 2.5 in the container; keep the older build's result
    2.5 left 175 connections open on this board against 17, and its native
    CLI build crashes on start. Java 25 is added to the dev image so the jar
    can be run for comparison.
2026-10-16 Route the last connection; add DNA board authentication and a printed case
2026-10-16 Coupled 90-ohm USB pair, production silkscreen, firmware and driver side of board authentication, ISE container
2026-10-16 Manufacturing package, parts list, end-of-line provisioning tool, manufacturing guide, case labels
2026-10-16 ERC clean: remove stray power symbol; schematic page fits; print-ready case STLs
2026-10-16 SDRAM deep buffer: 32 M samples at up to 100 MS/s, verified against a timing-checking SDRAM model
