OutBlade/s6la8/(notices)

Notices in the files:
host/driver/api.c:
the Free Software Foundation, either version 3 of the License, or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
